mossmann/fireflycap/README

Firefly Cap

an electronics kit for building a jar of fireflies or powering
your own device with indoor photovoltaic energy harvesting

author: Michael Ossmann <mike@ossmann.com>
project home: http://greatscottgadgets.com/fireflycap/
