mossmann/fireflycap/doc/README

The pdf schematic represents the current prototype or released
design.  For the most recent design in development, refer to
the KiCad files in ../hardware/.

Technical documentation is being developed at:

https://github.com/mossmann/fireflycap/wiki
