mossmann/fireflycap/doc/fireflycap-schematic.pdf

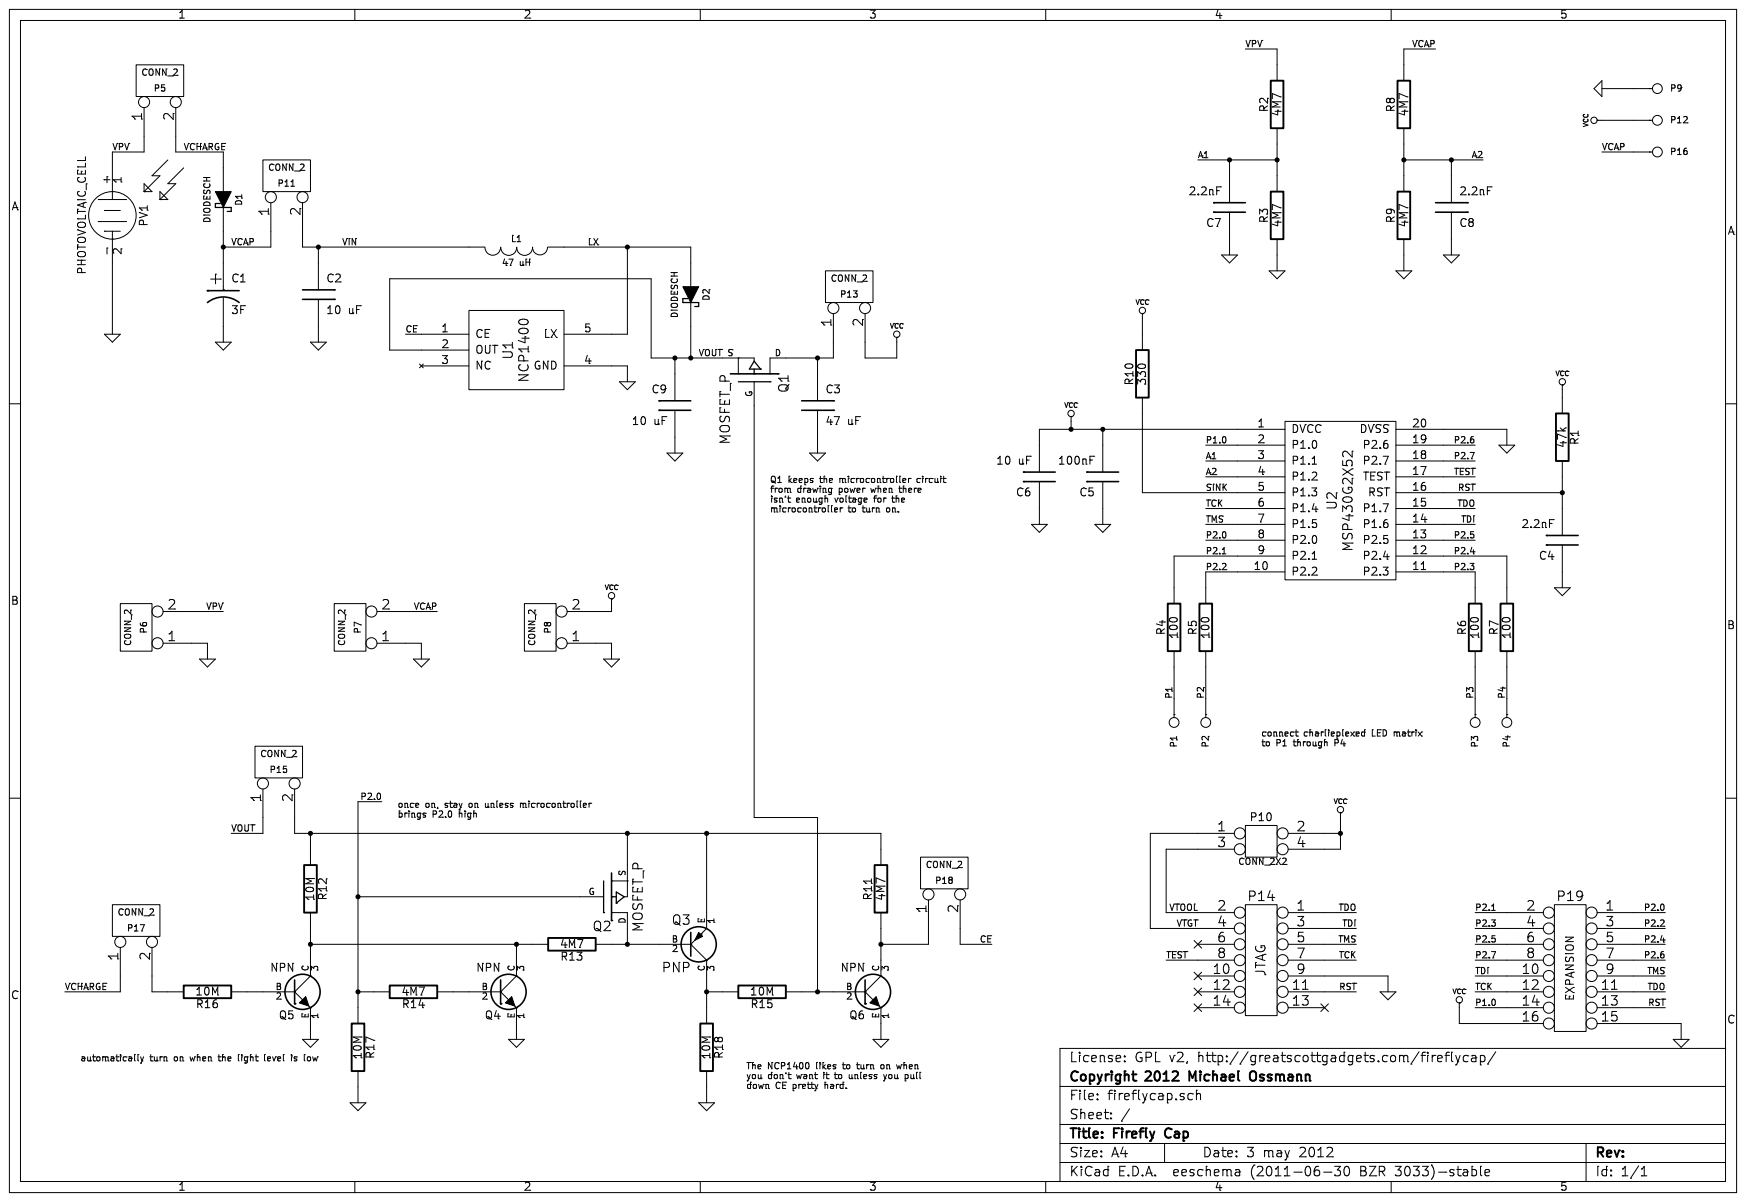
[picture p1: page 1]
