mossmann/fireflycap/hardware/fireflycap.sch

## KiCad design hardware/fireflycap.sch (2012-05-10, an earlier design)

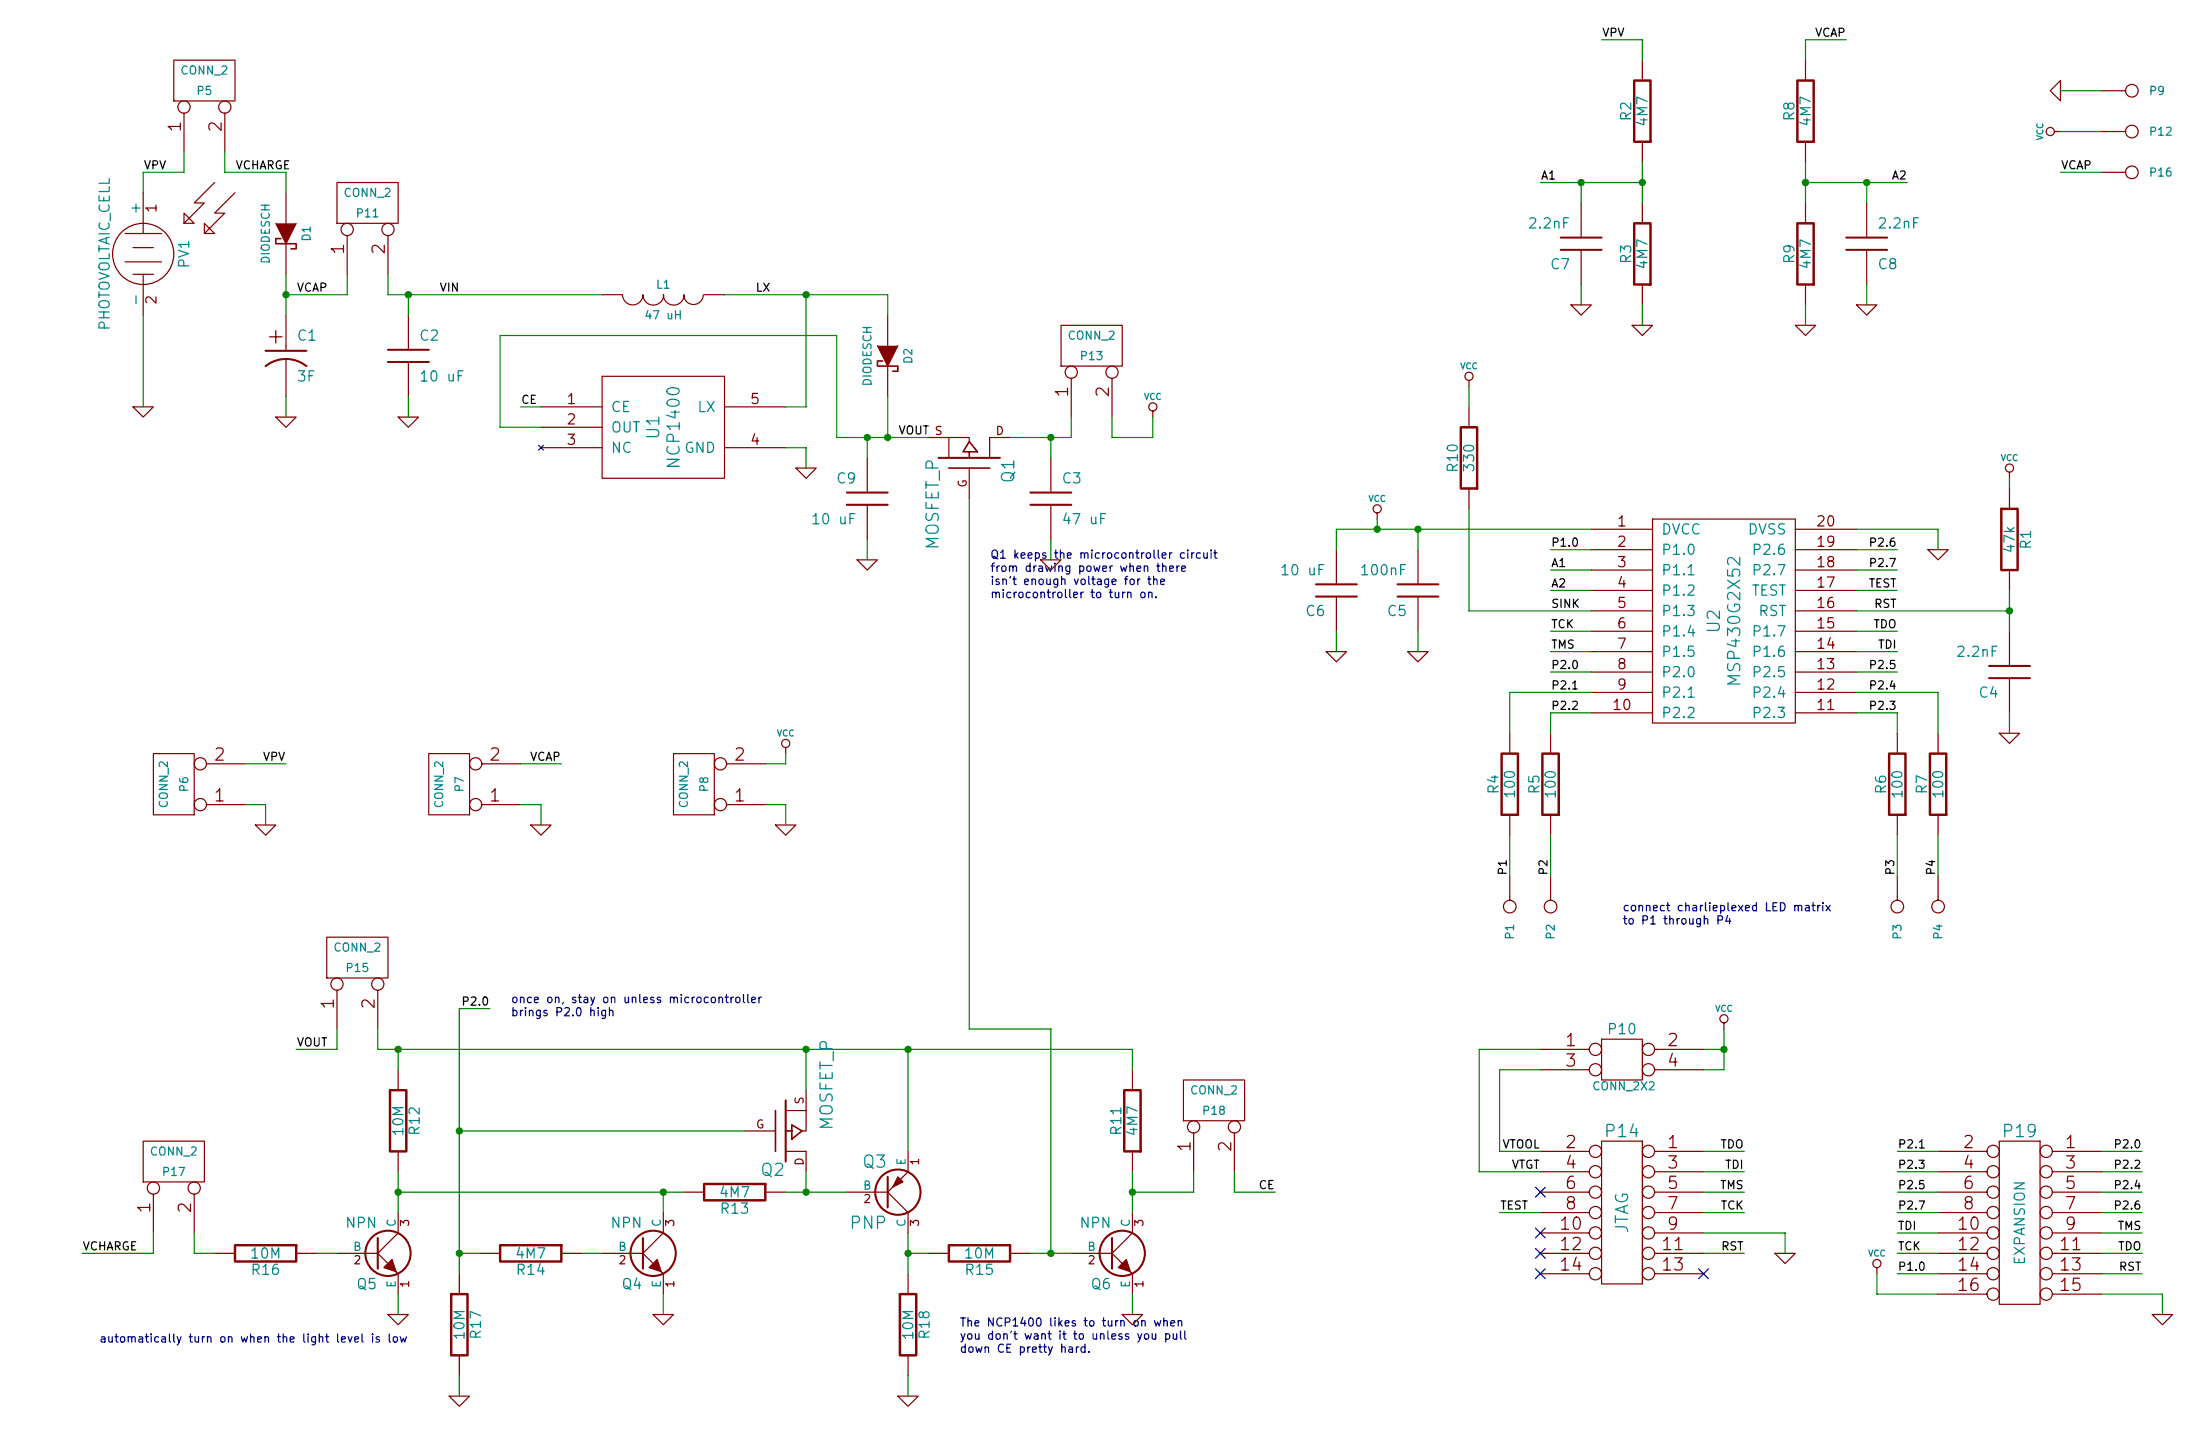
[picture p2: schematic fireflycap.sch]

Parts:
C1: 3F; GSG-ESHSR-0003-SIDE; Part Number ESHR-0003C0-002R7
C2, C6, C9: 10 uF; GSG-0805; Part Number GRM21BR61A106KE19L
C3: 47 uF; GSG-1206; Part Number LMK316BJ476ML-T
C4: 2.2nF; GSG-0603
C5: 100nF; GSG-0603; Part Number GRM188R71E104KA01J
C7, C8: 2.2nF; GSG-0805
D1, D2: DIODESCH; GSG-SOD-523F; Part Number RB751S40
L1: 47 uH; GSG-1210; Part Number LBC3225T470KR
P1, P2, P3, P4: CONN_1; GSG-PINTST
P5, P6, P7, P8: CONN_2; GSG-HEADER-SMD-2x1
P9, P12, P16: CONN_1; GSG-TESTPOINT
P10: CONN_2X2; GSG-HEADER-SMD-2x2
P11, P13, P15, P17, P18: CONN_2; GSG-HEADER-SMD-2x1-BRIDGED
P14: JTAG; GSG-HEADER-SMD-2x7
P19: EXPANSION; GSG-HEADER-2x8
PV1: PHOTOVOLTAIC_CELL; AM-1454; Part Number AM-1454CA
Q1, Q2: MOSFET_P; SOT23GDS; Part Number BSS84
Q3: PNP; SOT23EBC; Part Number MMBT3906-7-F
Q4, Q5, Q6: NPN; SOT23EBC; Part Number MMBT3904-7-F
R1: 47k; GSG-0603
R2, R3, R8, R9, R11, R13, R14: 4M7; GSG-0805
R4, R5, R6, R7: 100; GSG-0603; Part Number ERJ-3GEYJ101V
R10: 330; GSG-0603; Part Number ERJ-3GEYJ101V
R12, R15, R16, R17, R18: 10M; GSG-0805
U1: NCP1400; SOT23-5; Part Number NCP1400ASN27T1G
U2: MSP430G2X52; GSG-TSSOP20; Part Number MSP430G2452IPW20R

Connections:
A1: C7.2, R2.1, R3.2, U2.3 (P1.1)
A2: C8.2, R8.1, R9.2, U2.4 (P1.2)
CE: P18.2 (PM), U1.1 (CE)
GND: C1.2, C2.2, C3.2, C4.1, C5.1, C6.1, C7.1, C8.1, C9.2, P6.1, P7.1, P8.1, P9.1, P14.9, P19.15, PV1.2 (-), Q4.1 (E), Q5.1 (E), Q6.1 (E), R3.1, R9.1, R17.2, R18.2, U1.4 (GND), U2.20 (DVSS)
LX: D2.1 (A), L1.1, U1.5 (LX)
unnamed: C3.1, P13.1, Q1.D
unnamed: P15.2 (PM), Q2.S, Q3.1 (E), R11.2, R12.1
unnamed: P17.2 (PM), R16.2
unnamed: P18.1, Q6.3 (C), R11.1
unnamed: Q1.G, Q6.2 (B), R15.1
unnamed: Q2.D, Q3.2 (B), R13.1
unnamed: Q3.3 (C), R15.2, R18.1
unnamed: Q4.2 (B), R14.1
unnamed: Q4.3 (C), Q5.3 (C), R12.2, R13.2
unnamed: Q5.2 (B), R16.1
P1: P1.1, R4.1
P1.0: P19.14, U2.2 (P1.0)
P2: P2.1, R5.1
P2.0: P19.1, Q2.G, R14.2, R17.1, U2.8 (P2.0)
P2.1: P19.2, R4.2, U2.9 (P2.1)
P2.2: P19.3, R5.2, U2.10 (P2.2)
P2.3: P19.4, R6.2, U2.11 (P2.3)
P2.4: P19.5, R7.2, U2.12 (P2.4)
P2.5: P19.6, U2.13 (P2.5)
P2.6: P19.7, U2.19 (P2.6)
P2.7: P19.8, U2.18 (P2.7)
P3: P3.1, R6.1
P4: P4.1, R7.1
RST: C4.2, P14.11, P19.13, R1.2, U2.16 (RST)
SINK: R10.1, U2.5 (P1.3)
TCK: P14.7, P19.12, U2.6 (P1.4)
TDI: P14.3, P19.10, U2.14 (P1.6)
TDO: P14.1, P19.11, U2.15 (P1.7)
TEST: P14.8, U2.17 (TEST)
TMS: P14.5, P19.9, U2.7 (P1.5)
VCAP: C1.1, D1.2 (K), P7.2 (PM), P11.1, P16.1, R8.2
VCC: C5.2, C6.2, P8.2 (PM), P10.2, P10.4, P12.1, P13.2 (PM), P19.16, R1.1, R10.2, U2.1 (DVCC)
VCHARGE: D1.1 (A), P5.2 (PM), P17.1
VIN: C2.1, L1.2, P11.2 (PM)
VOUT: C9.1, D2.2 (K), P15.1, Q1.S, U1.2 (OUT)
VPV: P5.1, P6.2 (PM), PV1.1 (+), R2.2
VTGT: P10.1, P14.4
VTOOL: P10.3, P14.2

Notes on the sheet:
The NCP1400 likes to turn on when you don't want it to unless you pull down CE pretty hard.
once on, stay on unless microcontroller brings P2.0 high
connect charlieplexed LED matrix to P1 through P4
automatically turn on when the light level is low
Q1 keeps the microcontroller circuit from drawing power when there isn't enough voltage for the microcontroller to turn on.
