mossmann/fireflycap/firmware/waveform.h

/*
 * Copyright 2012 Michael Ossmann
 *
 * This file is part of the Firefly Cap project.
 *
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
 * You should have received a copy of the GNU General Public License
 * along with this program; see the file COPYING.  If not, write to
 * the Free Software Foundation, Inc., 51 Franklin Street,
 * Boston, MA 02110-1301, USA.
 */

/*
 * Waveforms should be 256 byte arrays ending in zero.
 * They are "played" via PWM on the LEDs.
 */

/* 2.7 second Photuris pennsylvanicus waveform based on Barber's 1951 chart */
const uint8_t waveform[] = {
		0x01, 0x01, 0x02, 0x07, 0x0e, 0x1a, 0x45, 0x5a,
		0x82, 0x8b, 0x6b, 0x54, 0x26, 0x15, 0x0b, 0x03,
		0x02, 0x01, 0x01, 0x01, 0x01, 0x01, 0x01, 0x02,
		0x05, 0x09, 0x16, 0x1e, 0x35, 0x41, 0x51, 0x6b,
		0x7a, 0x97, 0xb0, 0xc0, 0xc0, 0xc0, 0xc0, 0xc0,
		0xc0, 0xc0, 0xc0, 0xc0, 0xb0, 0xb0, 0xb0, 0xb0,
		0xb0, 0xc0, 0xc0, 0xff, 0xff, 0xff, 0xff, 0xff,
		0xff, 0xff, 0xff, 0xff, 0xff, 0xff, 0xd6, 0xc0,
		0xc0, 0xd6, 0xff, 0xff, 0xff, 0xff, 0xff, 0xff,
		0xff, 0xff, 0xff, 0xff, 0xff, 0xff, 0xff, 0xff,
		0xff, 0xff, 0xff, 0xff, 0xff, 0xff, 0xff, 0xff,
		0xff, 0xff, 0xff, 0xff, 0xff, 0xff, 0xff, 0xff,
		0xff, 0xff, 0xff, 0xff, 0xff, 0xff, 0xff, 0xff,
		0xff, 0xff, 0xff, 0xff, 0xff, 0xff, 0xff, 0xff,
		0xff, 0xff, 0xff, 0xff, 0xff, 0xff, 0xff, 0xff,
		0xff, 0xff, 0xff, 0xff, 0xff, 0xff, 0xff, 0xff,
		0xff, 0xff, 0xff, 0xff, 0xff, 0xff, 0xff, 0xff,
		0xff, 0xff, 0xff, 0xff, 0xff, 0xff, 0xff, 0xff,
		0xff, 0xff, 0xff, 0xff, 0xff, 0xff, 0xff, 0xff,
		0xff, 0xff, 0xff, 0xff, 0xd6, 0xd6, 0xd6, 0xc0,
		0xc0, 0xc0, 0xc0, 0xc0, 0xc0, 0xc0, 0xb0, 0xb0,
		0xa2, 0x97, 0x97, 0x8b, 0x82, 0x7a, 0x72, 0x6b,
		0x64, 0x60, 0x54, 0x54, 0x51, 0x51, 0x4b, 0x4b,
		0x4b, 0x48, 0x48, 0x48, 0x45, 0x45, 0x41, 0x3e,
		0x3b, 0x3b, 0x35, 0x33, 0x2f, 0x2c, 0x2a, 0x28,
		0x25, 0x23, 0x22, 0x1f, 0x1e, 0x1c, 0x1c, 0x1b,
		0x1a, 0x19, 0x17, 0x16, 0x14, 0x13, 0x12, 0x11,
		0x10, 0x0f, 0x0e, 0x0e, 0x0d, 0x0c, 0x0b, 0x0a,
		0x0a, 0x09, 0x09, 0x08, 0x08, 0x08, 0x07, 0x07,
		0x07, 0x06, 0x06, 0x05, 0x05, 0x04, 0x04, 0x04,
		0x04, 0x03, 0x03, 0x03, 0x02, 0x02, 0x02, 0x02,
		0x01, 0x01, 0x01, 0x01, 0x01, 0x01, 0x01, 0x00
};
