mossmann/fireflycap/(commit log)

2012-05-04 added hardware
    [fireflycap.brd, fireflycap.sch]
2012-05-04 added schematic pdf
2012-05-08 bom corrections
    [fireflycap.sch]
2012-05-10 filled in bom info for some passives
    [fireflycap.sch]
