mossmann/fireflycap/(notices)

Notices in the files:
hardware/fireflycap.sch:
License: GPL v2, http://greatscottgadgets.com/fireflycap
